bikerglen/p1am-proto-experiments/README.md

# p1am-proto-experiments
Various board and libraries to fit the Automation Direct P1AM-PROTO enclosure.
Everything here is untested. Use at your own risk. I'll accept pull requests with any corrections or other contributions.
