bikerglen/p1am-proto-experiments/p1am-isolated-rs485/boards/v1/p1am-proto-iso-rs485-schematic.png

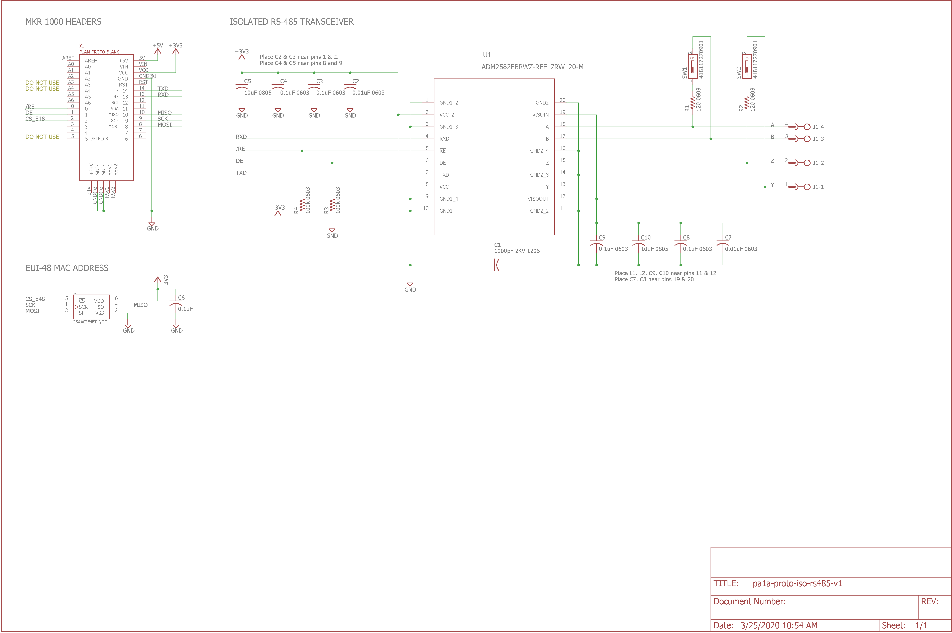
p1am-isolated-rs485/boards/v1/p1am-proto-iso-rs485-schematic.png
