bikerglen/p1am-proto-experiments/p1am-isolated-2x2-gpio/boards/v1/P1AM-ISOLATED-2X2-GPIO-BOM.xlsx

Qty | Ref | Description | Package | Mfr | Mfr Part # | Supplier | Supplier Part #
2 | C1, C2 | CAP CER 4.7UF 16V X7R 1206 | 1206 | Kemet | C1206C475K4RACTU | Digi-Key | 399-3524-1-ND
1 | C3 | CAP CER 0.1UF 16V X7R 1206 | 1206 | Kemet | C1206C104K4RACTU | Digi-Key | 399-9305-1-ND
1 | C4 | CAP CER 0.1UF 10V X7R 0805 | 0805 | Kemet | C0805C104K8RACTU | Digi-Key | 399-7999-1-ND
1 | C5 | CAP CER 1000pF 2KV 10% X7R SMD 1206 | 1206 | Johanson Dielectrics | 202R18W102KV4E | Digi-Key | 709-1036-1-ND
1 | C6 | CAP CER 0.1UF 50V X7R 0603 | 0603 | Kemet | C0603C104K5RACTU | Digi-Key | 399-5089-1-ND
2 | D1, D2 | DIODE GEN PURP 100V 150MA SOD123 | SOD123 | Micro Commercial Co | 1N4148W-TP | Digi-Key | 1N4148WTPMSCT-ND
1 | D3 | TVS DIODE 12V 29.5V SOD323 | SOD323 | Bourns Inc. | CDSOD323-T12SC | Digi-Key | CDSOD323-T12SCCT-ND
1 | D4 | TVS DIODE 7V/12V 14V/26V SOT23-3 | SOT23 | Bourns Inc. | CDSOT23-SM712 | Digi-Key | CDSOT23-SM712CT-ND
1 | DISP1-DISPLAY | LED DISPLAY 5X7 4CHAR 5MM RED | --- | Broadcom | HCMS-3962 | Digi-Key | 516-3920-ND
1 | DISP1-SOCKET | CONN IC DIP SOCKET 12POS GOLD | --- | Mill-Max | 299-43-312-11-001000 | Digi-Key | ED90160-ND
1 | J1 | CONN MOD JACK 8P8C R/A SHIELDED | 8P8C | TE Connectivity | 5558342-1 | Digi-Key | A31466-ND
1 | J2-HEADER | TERM BLOCK HDR 8POS 90DEG 3.5MM | --- | Würth Elektronik | 691322110008 | Digi-Key | 732-2774-ND
1 | J2-PLUG | TERM BLOCK PLUG 8POS STR 3.5MM | --- | Würth Elektronik | 691361100008 | Digi-Key | 732-2756-ND
2 | JP1, JP2 | CONN HEADER VERT 4POS 2.54MM | --- | Samtec | TSW-104-07-G-S | Digi-Key | SAM1029-04-ND
2 | K1, K2 | RELAY GEN PURPOSE SPDT 1A 5VDC | --- | Omron | G5V-1-DC5 | Digi-Key | Z773-ND
1 | PS1 | DC DC CONVERTER 5V 1W | --- | Cui | PDS1-S5-S5-S | Digi-Key | 102-2758-ND
2 | Q1, Q2 | TRANS NPN 50V 2A SOT23-3 | --- | Diodes Incorporated | FMMT619TA | Digi-Key | FMMT619CT-ND
2 | R1, R2 | RES SMD 750 OHM 5% 1/4W 1206 | 1206 | Panasonic | ERJ-8GEYJ751V | Digi-Key | P750ECT-ND
1 | R3 | RES SMD 120 OHM 5% 1/8W 0805 | 0805 | Panasonic | ERJ-6GEYJ121V | Digi-Key | P120ACT-ND
3 | R4, R7, R8 | RES SMD 10K OHM 5% 1/8W 0805 | 0805 | Panasonic | ERJ-6GEYJ103V | Digi-Key | P10KACT-ND
2 | R5, R6 | RES SMD 1K OHM 5% 1/4W 1206 | 1206 | Panasonic | ERJ-8GEYJ102V | Digi-Key | P1.0KECT-ND
1 | U1 | IC TRANSCEIVER HALF 1/1 8SOIC | --- | Texas Instruments | SN65HVD11DR | Digi-Key | 296-31717-1-ND
2 | U2,U3 | OPTOISO 3.75KV TRANSISTOR 4SOIC | --- | Broadcom | HCPL-181-000E | Digi-Key | 516-1646-1-ND
1 | U4 | IC EEPROM 2K SPI 10MHZ SOT23-6 | --- | Microchip | 25AA02E48T-I/OT | Digi-Key | 25AA02E48T-I/OTCT-ND
1 | X1 | P1AM PROTOTYPE HOUSING | --- | Automation Direct | P1AM-PROTO | Automation Direct | P1AM-PROTO
