bikerglen/p1am-proto-experiments/p1am-isolated-rs485/boards/v1/p1am-proto-iso-rs485-v1.brd

## EAGLE design p1am-isolated-rs485/boards/v1/p1am-proto-iso-rs485-v1.brd (2020-03-25)

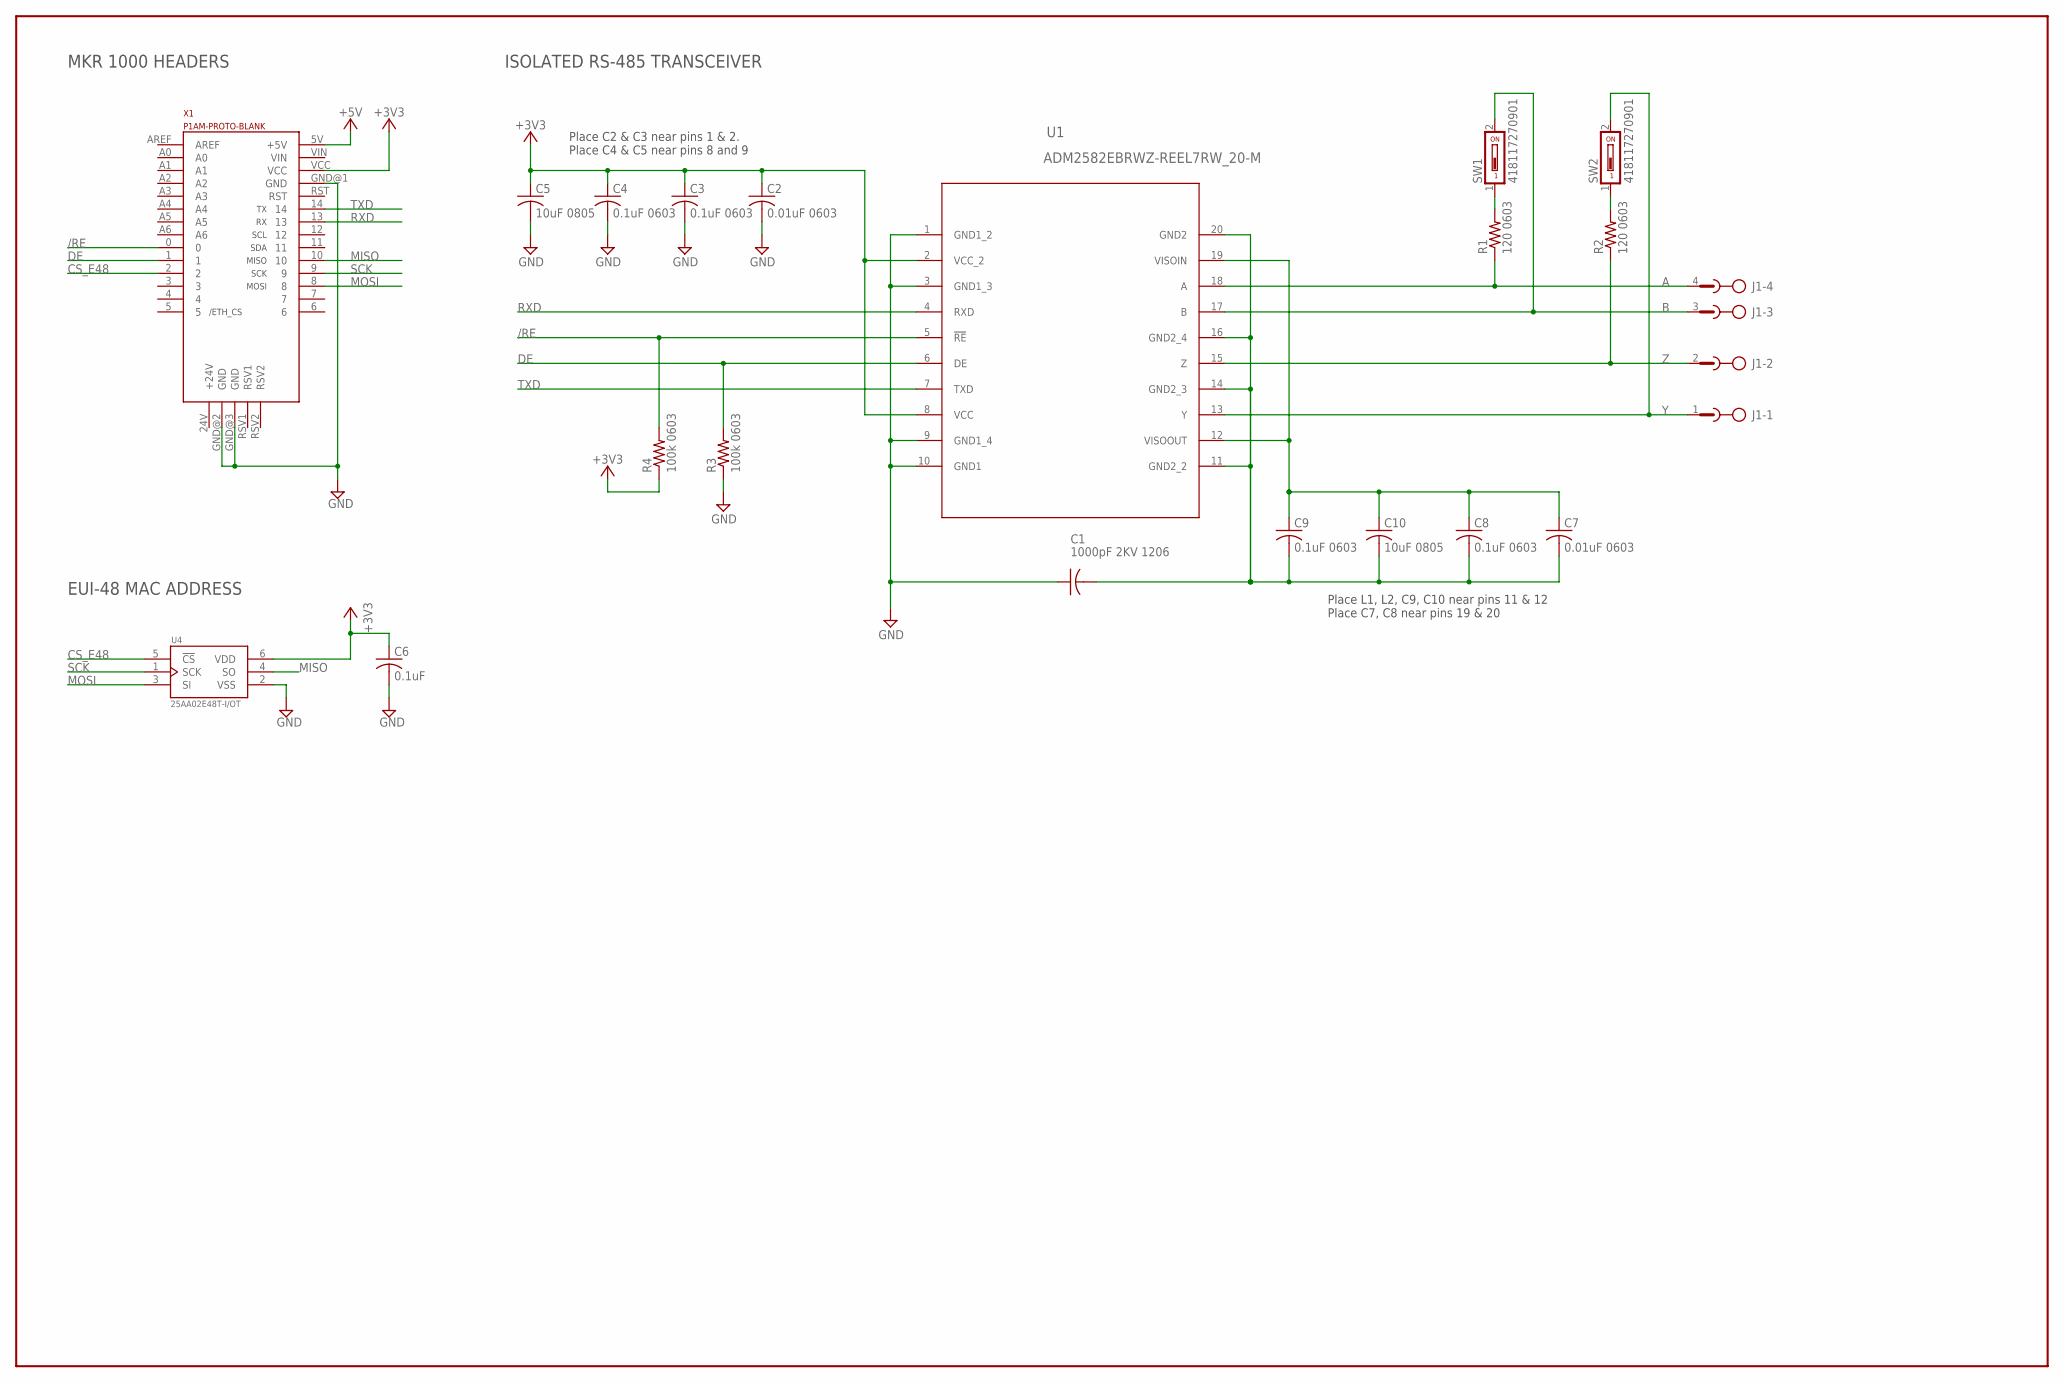
[picture p3: schematic p1am-proto-iso-rs485-v1.sch]

Parts:
C1: 1000pF 2KV 1206; C1206K
C2, C7: 0.01uF 0603; C0603K
C3, C4, C8, C9: 0.1uF 0603; C0603K
C5, C10: 10uF 0805; C0805K
C6: 0.1uF; C0603
J1: PHOENIX-XXXXXXX-TERM-BLOCK-HDR-4POS-90DEG-3.5MM
R1, R2: 120 0603; R0603
R3, R4: 100k 0603; R0603
SW1, SW2: 418117270901; DIP-01-PTH
U1: ADM2582EBRWZ-REEL7RW_20-M; RW_20-M
U4: 25AA02E48T-I/OT; SOT95P270X145-6N
X1: P1AM-PROTO-BLANK

Connections:
+3V3: C2.1, C3.1, C4.1, C5.1, C6.1, R4.1, U1.2 (VCC_2), U1.8 (VCC), U4.6 (VDD), X1.VCC
+5V: X1.5V (+5V)
/RE: R4.2, U1.5 (!RE), X1.0
A: J1.4, R1.1, U1.18 (A)
B: J1.3, SW1.2, U1.17 (B)
CS_E48: U4.5 (!CS), X1.2
DE: R3.2, U1.6 (DE), X1.1
GND: C1.1, C2.2, C3.2, C4.2, C5.2, C6.2, R3.1, U1.1 (GND1_2), U1.3 (GND1_3), U1.9 (GND1_4), U1.10 (GND1), U4.2 (VSS), X1.GND@1 (GND), X1.GND@2 (GND), X1.GND@3 (GND)
ISOGND: C1.2, C7.2, C8.2, C9.2, C10.2, U1.11 (GND2_2), U1.14 (GND2_3), U1.16 (GND2_4), U1.20 (GND2)
ISOVCC: C7.1, C8.1, C9.1, C10.1, U1.12 (VISOOUT), U1.19 (VISOIN)
MISO: U4.4 (SO), X1.10
MOSI: U4.3 (SI), X1.8
unnamed: R1.2, SW1.1
unnamed: R2.2, SW2.1
RXD: U1.4 (RXD), X1.13
SCK: U4.1 (SCK), X1.9
TXD: U1.7 (TXD), X1.14
Y: J1.1, SW2.2, U1.13 (Y)
Z: J1.2, R2.1, U1.15 (Z)

Notes on the sheet:
SCL
SDA
MISO
MOSI
SCK
/ETH_CS
MKR 1000 HEADERS
EUI-48 MAC ADDRESS
ISOLATED RS-485 TRANSCEIVER
Place C2 & C3 near pins 1 & 2. Place C4 & C5 near pins 8 and 9
Place L1, L2, C9, C10 near pins 11 & 12 Place C7, C8 near pins 19 & 20

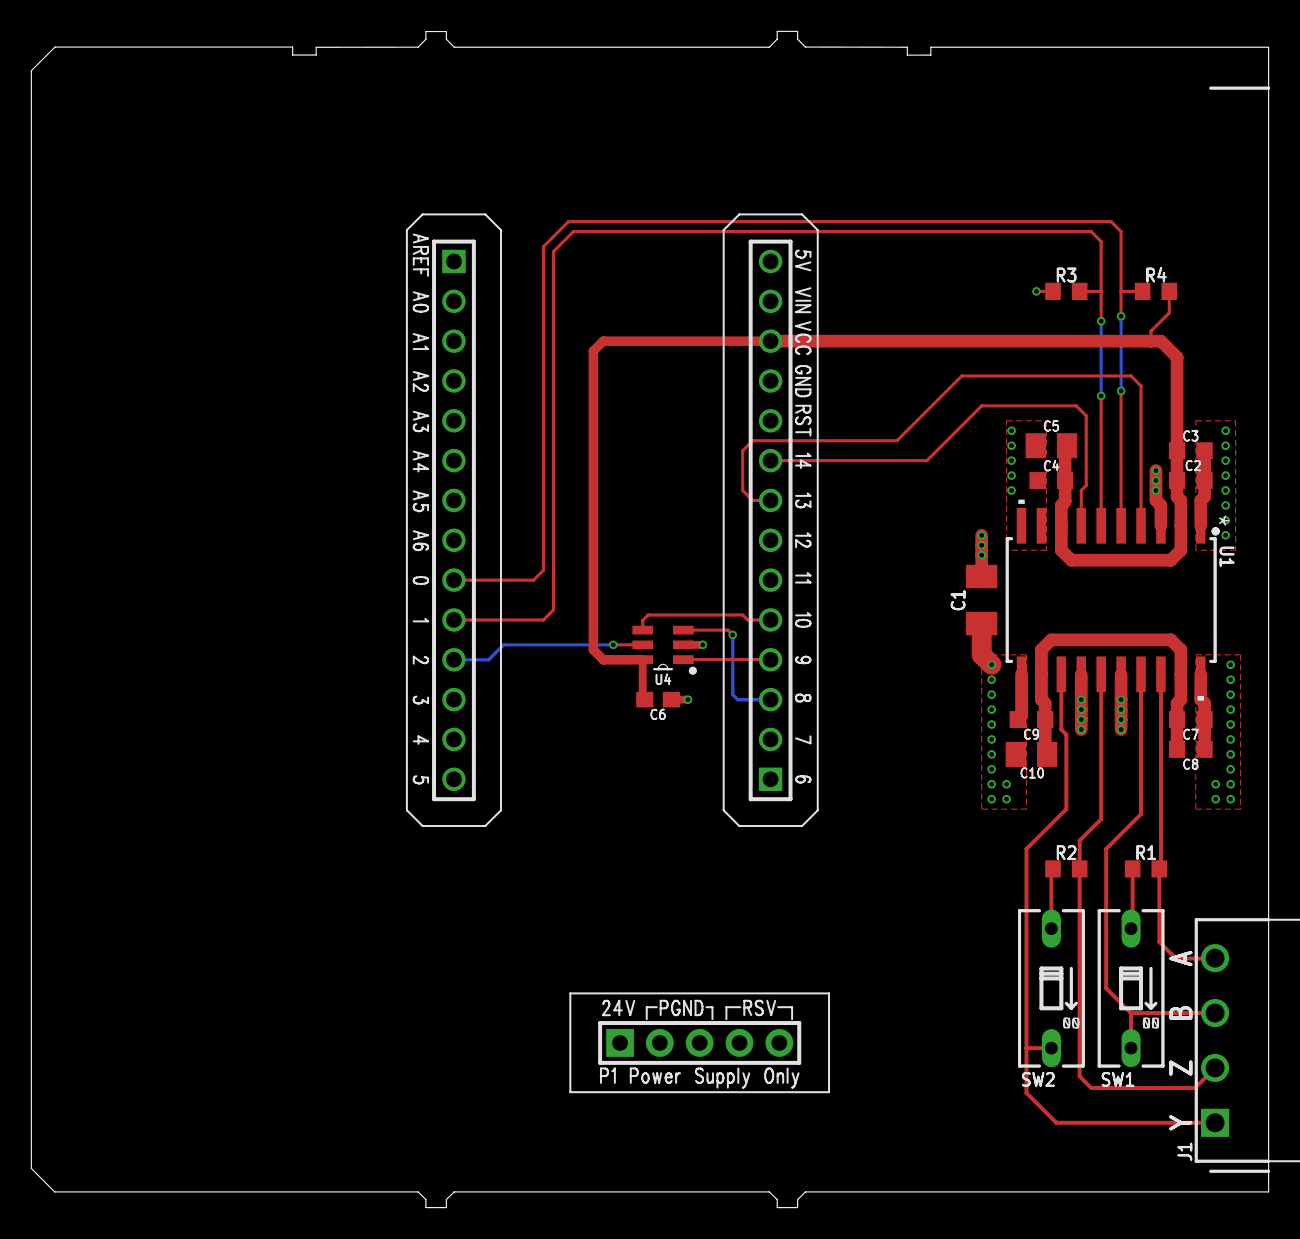
[picture p4: board p1am-proto-iso-rs485-v1.brd from above]

Board: 2 copper layers, 78.9 x 75.0 mm, 20 parts (0 on the bottom side), 18 nets.
