bikerglen/p1am-proto-experiments/p1am-isolated-2x2-gpio/boards/v1/P1AM-ISOLATED-2X2-GPIO.brd

## EAGLE design p1am-isolated-2x2-gpio/boards/v1/P1AM-ISOLATED-2X2-GPIO.brd (2020-03-22)

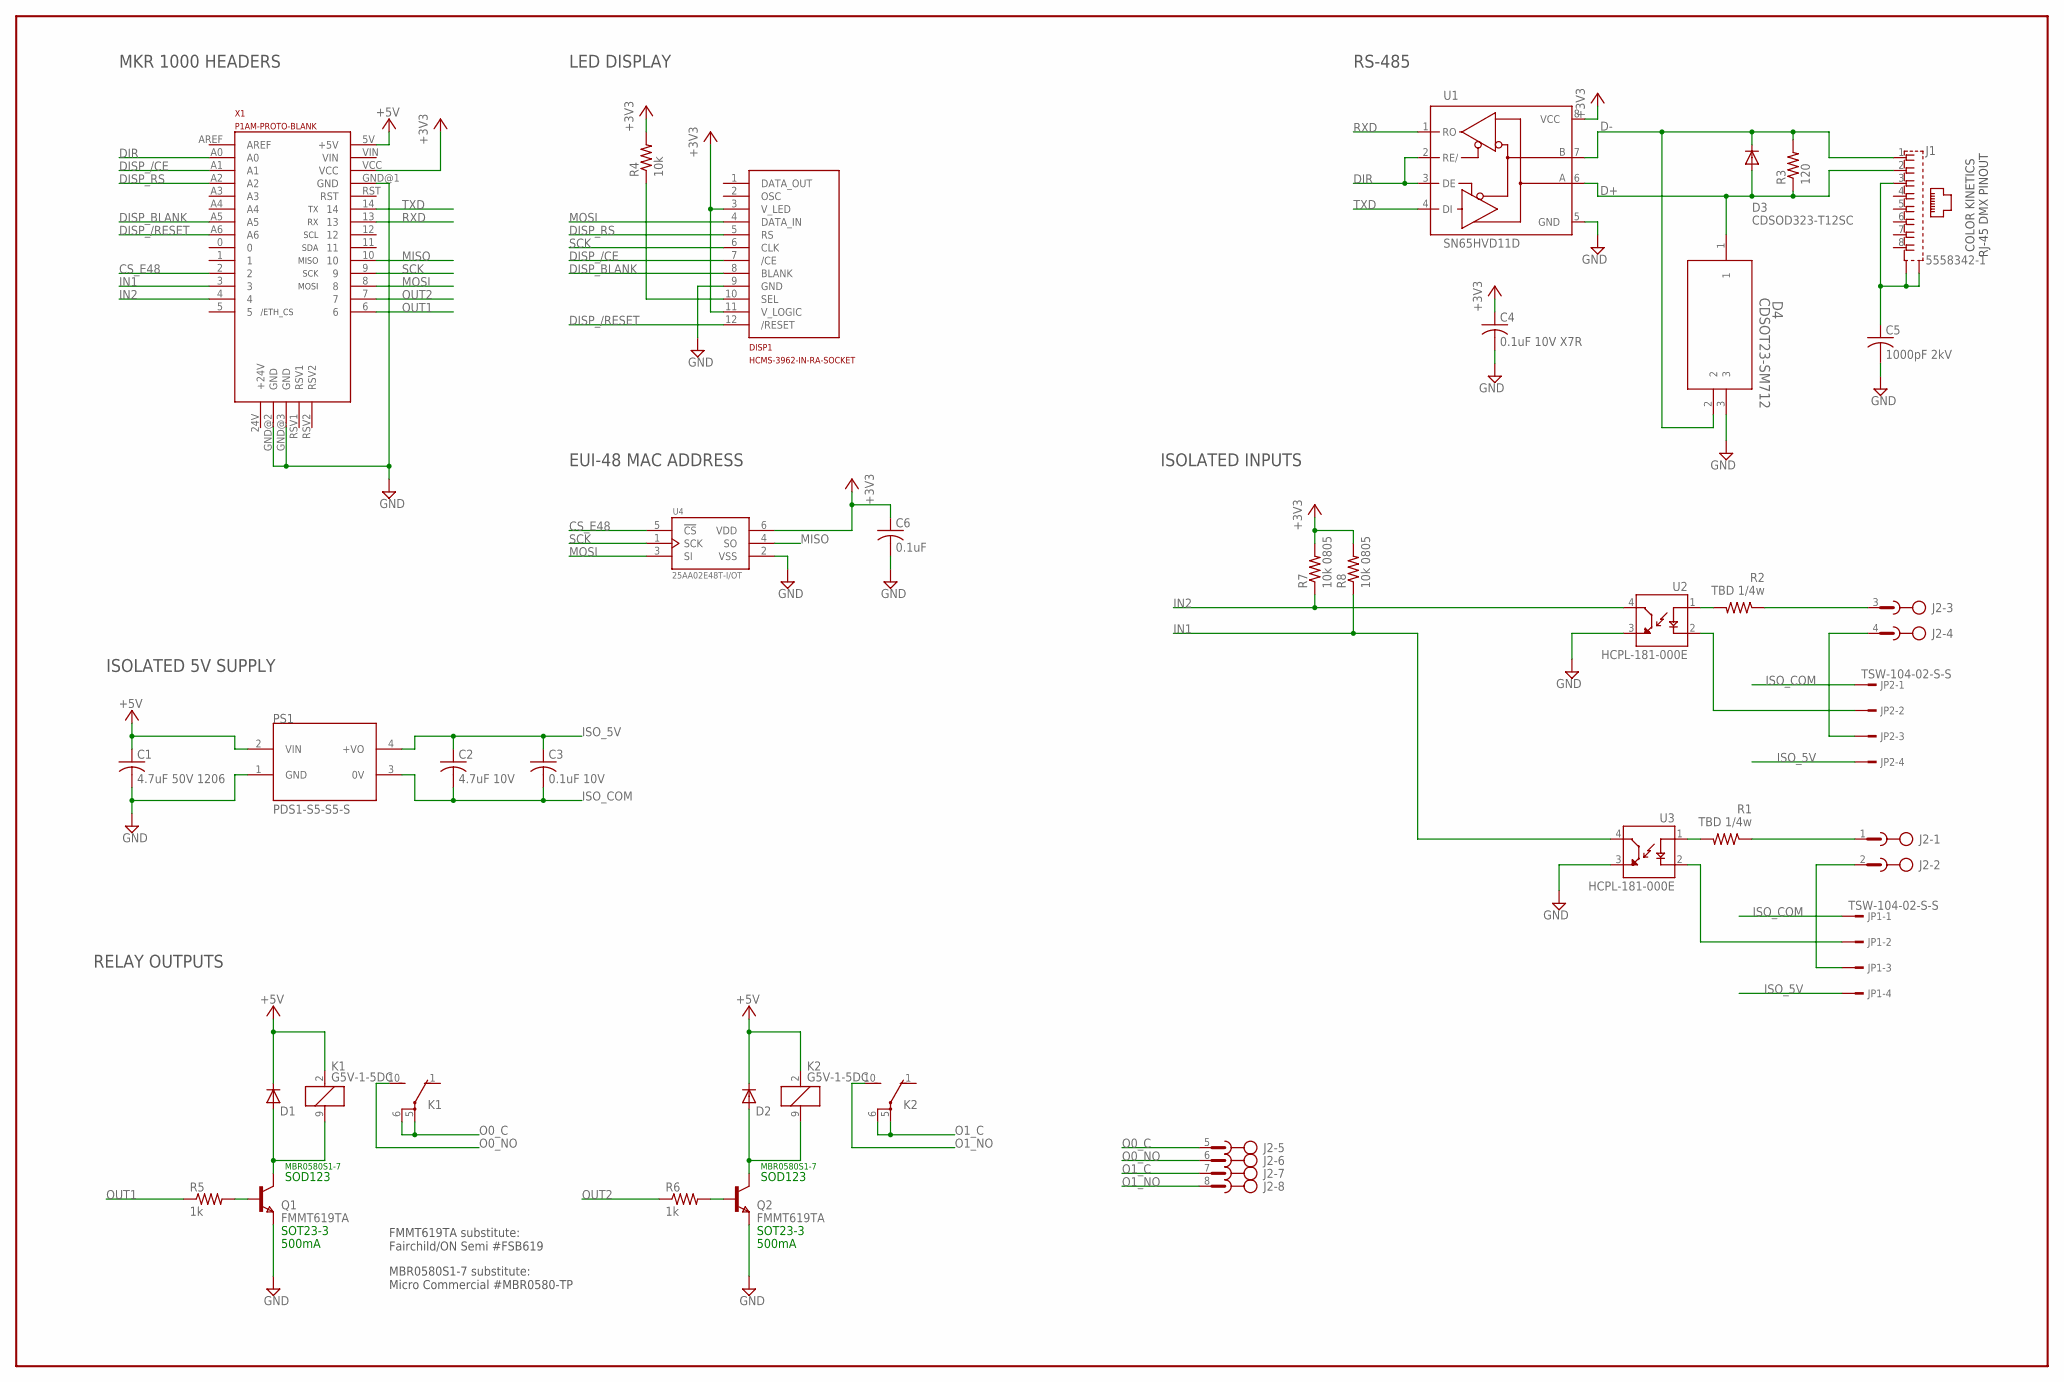
[picture p5: schematic P1AM-ISOLATED-2X2-GPIO.sch]

Parts:
C1: 4.7uF 50V 1206; C1206K; MFR_PART_NO C1206C475K5RACTU
C2: 4.7uF 10V; C1206K
C3: 0.1uF 10V; C1206K; MFR_PART_NO C1206C475K5RACTU
C4: 0.1uF 10V X7R; C0805
C5: 1000pF 2kV; C1206K
C6: 0.1uF; C0603
D1, D2: 1N4148W-TP; SOD123; MFR_PART_NO MBR0580S1-7
D3: CDSOD323-T12SC; SOD323-W
D4: CDSOT23-SM712; SOT_SM712
DISP1: HCMS-3962-IN-RA-SOCKET; 299-43-312-11-001000
J1: 5558342-1; TE_5558342-1
J2: PHOENIX-XXXXXXX-TERM-BLOCK-HDR-8POS-90DEG-3.5MM
JP1, JP2: TSW-104-02-S-S
K1, K2: G5V-1-5DC; G5V1; MFR_PART_NO G5V-1-DC5
PS1: PDS1-S5-S5-S; CONV_PDS1-S5-S5-S
Q1, Q2: FMMT619TA; SOT-23; MFR_PART_NO FMMT619TA
R1, R2: TBD 1/4w; R1206
R3: 120; R0805
R4: 10k; R0805
R5, R6: 1k; R1206; MFR_PART_NO CR1206-JW-102ELF
R7, R8: 10k 0805; R0805
U1: SN65HVD11D; SO08
U2, U3: HCPL-181-000E; SOIC254P675X240-4N
U4: 25AA02E48T-I/OT; SOT95P270X145-6N
X1: P1AM-PROTO-BLANK

Connections:
+3V3: C4.1, C6.1, DISP1.3 (V_LED), DISP1.11 (V_LOGIC), R4.2, R7.2, R8.2, U1.8 (VCC), U4.6 (VDD), X1.VCC
+5V: C1.1, D1.C, D2.C, K1.2 (1), K2.2 (1), PS1.2 (VIN), X1.5V (+5V)
CS_E48: U4.5 (!CS), X1.2
D+: D3.A, D4.1, J1.2, R3.1, U1.6 (A)
D-: D3.C, D4.2, J1.1, R3.2, U1.7 (B)
DIR: U1.2 (RE/), U1.3 (DE), X1.A0
DISP_/CE: DISP1.7 (/CE), X1.A1
DISP_/RESET: DISP1.12 (/RESET), X1.A6
DISP_BLANK: DISP1.8 (BLANK), X1.A5
DISP_RS: DISP1.5 (RS), X1.A2
GND: C1.2, C4.2, C5.2, C6.2, D4.3, DISP1.9 (GND), PS1.1 (GND), Q1.2 (E), Q2.2 (E), U1.5 (GND), U2.3 (EMITTER), U3.3 (EMITTER), U4.2 (VSS), X1.GND@1 (GND), X1.GND@2 (GND), X1.GND@3 (GND)
IN1: R8.1, U3.4 (COLLECTOR), X1.3
IN2: R7.1, U2.4 (COLLECTOR), X1.4
ISO_5V: C2.1, C3.1, JP1.4, JP2.4, PS1.4 (+VO)
ISO_COM: C2.2, C3.2, JP1.1, JP2.1, PS1.3 (0V)
MISO: U4.4 (SO), X1.10
MOSI: DISP1.4 (DATA_IN), U4.3 (SI), X1.8
unnamed: R1.2, U3.1 (ANODE)
unnamed: JP1.2, U3.2 (CATHODE)
unnamed: Q2.3 (B), R6.2
unnamed: D2.A, K2.9 (2), Q2.1 (C)
unnamed: J2.3, R2.1
unnamed: J2.2, JP1.3
unnamed: R2.2, U2.1 (ANODE)
unnamed: JP2.2, U2.2 (CATHODE)
unnamed: J2.1, R1.1
unnamed: J2.4, JP2.3
unnamed: C5.1, J1.3, J1.SH1 (S1), J1.SH2 (S2)
unnamed: DISP1.10 (SEL), R4.1
unnamed: Q1.3 (B), R5.2
unnamed: D1.A, K1.9 (2), Q1.1 (C)
O0_C: J2.5, K1.5, K1.6
O0_NO: J2.6, K1.10 (S)
O1_C: J2.7, K2.5, K2.6
O1_NO: J2.8, K2.10 (S)
OUT1: R5.1, X1.6
OUT2: R6.1, X1.7
RXD: U1.1 (RO), X1.13
SCK: DISP1.6 (CLK), U4.1 (SCK), X1.9
TXD: U1.4 (DI), X1.14

Notes on the sheet:
SOD123
SOT23-3
500mA
MBR0580S1-7
FMMT619TA substitute: Fairchild/ON Semi #FSB619
MBR0580S1-7 substitute: Micro Commercial #MBR0580-TP
COLOR KINETICS RJ-45 DMX PINOUT
SCL
SDA
MISO
MOSI
SCK
/ETH_CS
RS-485
ISOLATED INPUTS
RELAY OUTPUTS
MKR 1000 HEADERS
LED DISPLAY
EUI-48 MAC ADDRESS
ISOLATED 5V SUPPLY

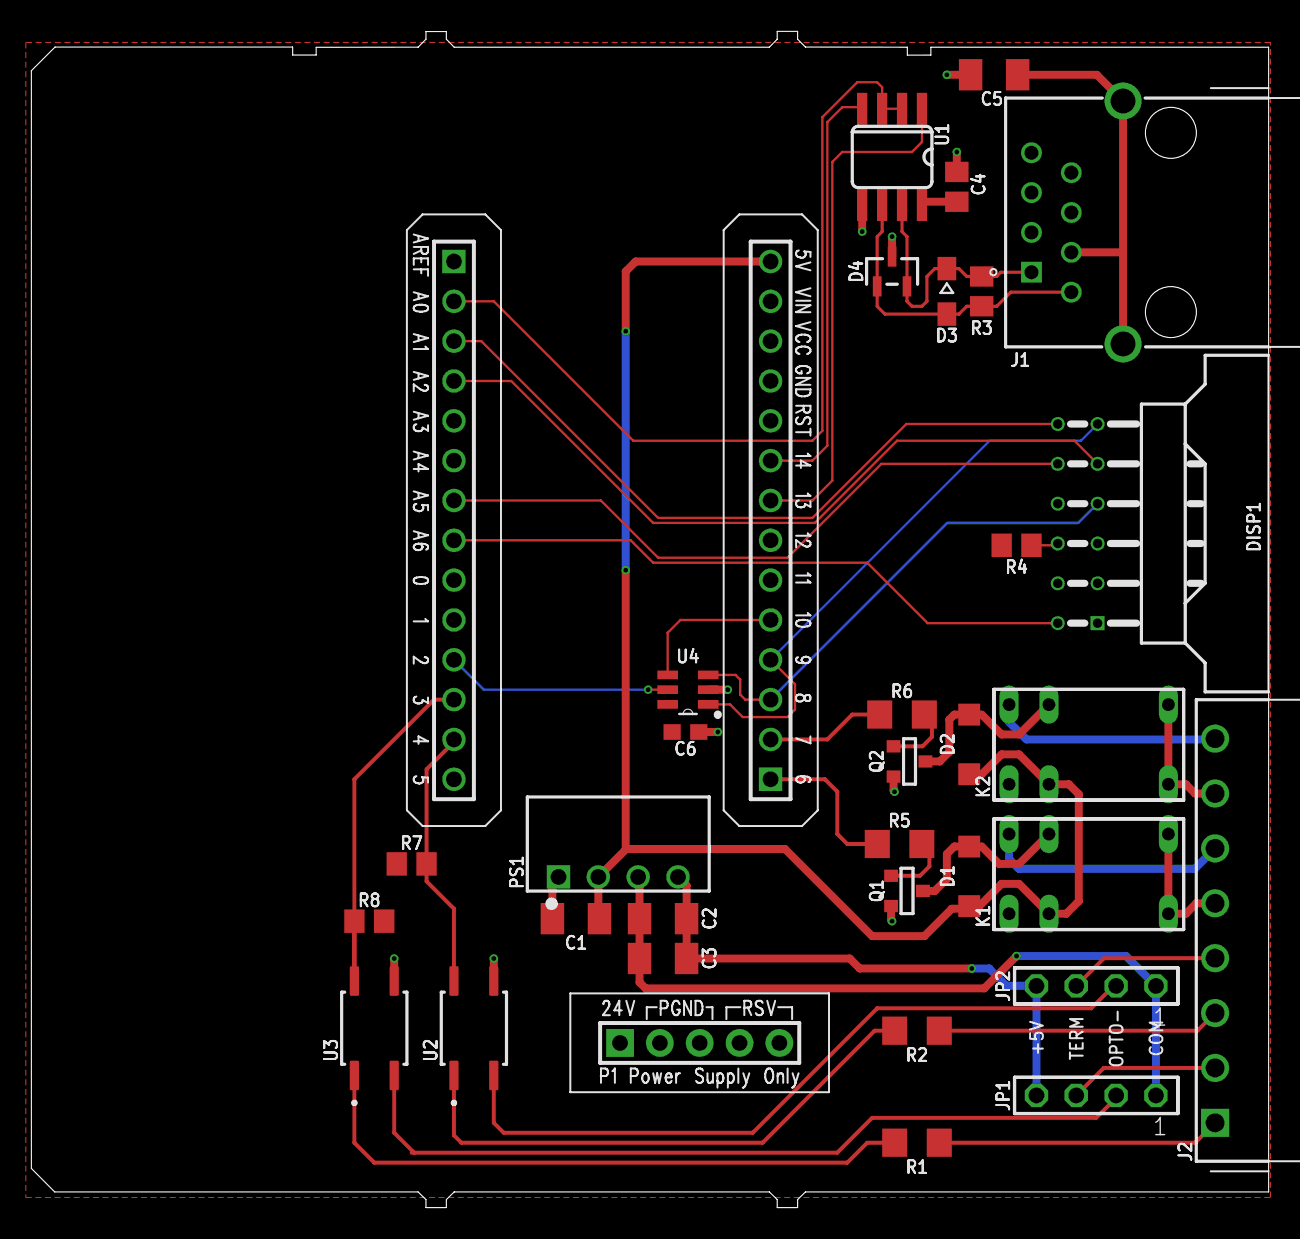
[picture p6: board P1AM-ISOLATED-2X2-GPIO.brd from above]

Board: 2 copper layers, 78.9 x 75.0 mm, 33 parts (0 on the bottom side), 40 nets.
