bikerglen/p1am-proto-experiments/p1am-isolated-2x2-gpio/sketches/p1am-100-garage-door-monitor/charrom.cpp

//-----------------------------------------------------------------------------
// includes

#include "charrom.h"


//-----------------------------------------------------------------------------
// globals
//

const unsigned char charrom[128][5] = {
	{ 0x7f, 0x00, 0x00, 0x00, 0x00 }, // bar graph 1
	{ 0x7f, 0x7f, 0x00, 0x00, 0x00 },
	{ 0x7f, 0x7f, 0x7f, 0x00, 0x00 },
	{ 0x7f, 0x7f, 0x7f, 0x7f, 0x00 },
	{ 0x7f, 0x7f, 0x7f, 0x7f, 0x7f },
	{ 0, 0, 0, 0, 0 },
	{ 0, 0, 0, 0, 0 },
	{ 0, 0, 0, 0, 0 },

	{ 0x00, 0x00, 0x00, 0x00, 0x7f }, // bar graph 2
	{ 0x00, 0x00, 0x00, 0x7f, 0x7f },
	{ 0x00, 0x00, 0x7f, 0x7f, 0x7f },
	{ 0x00, 0x7f, 0x7f, 0x7f, 0x7f },
	{ 0x7f, 0x7f, 0x7f, 0x7f, 0x7f },
	{ 0, 0, 0, 0, 0 },
	{ 0, 0, 0, 0, 0 },
	{ 0, 0, 0, 0, 0 },

	{ 0, 0, 0, 0, 0 }, { 0, 0, 0, 0, 0 },
	{ 0, 0, 0, 0, 0 }, { 0, 0, 0, 0, 0 },
	{ 0, 0, 0, 0, 0 }, { 0, 0, 0, 0, 0 },
	{ 0, 0, 0, 0, 0 }, { 0, 0, 0, 0, 0 },
	{ 0, 0, 0, 0, 0 }, { 0, 0, 0, 0, 0 },
	{ 0, 0, 0, 0, 0 }, { 0, 0, 0, 0, 0 },
	{ 0, 0, 0, 0, 0 }, { 0, 0, 0, 0, 0 },
	{ 0, 0, 0, 0, 0 }, { 0, 0, 0, 0, 0 },

	{ 0x00, 0x00, 0x00, 0x00, 0x00 }, // 0x20 space
	{ 0x00, 0x4f, 0x00, 0x00, 0x00 }, // !
	{ 0x00, 0x03, 0x00, 0x03, 0x00 }, // "
	{ 0x14, 0x7f, 0x14, 0x7f, 0x14 }, // #
	{ 0x24, 0x2a, 0x7f, 0x2a, 0x12 }, // $
	{ 0x23, 0x13, 0x08, 0x64, 0x62 }, // %
	{ 0x36, 0x49, 0x56, 0x20, 0x50 }, // &
	{ 0x00, 0x0b, 0x07, 0x00, 0x00 }, // '
	{ 0x00, 0x00, 0x3e, 0x41, 0x00 }, // 0x28 (
	{ 0x00, 0x41, 0x3e, 0x00, 0x00 }, // )
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
	{ 0x04, 0x48, 0x30, 0x08, 0x04 }, // y
	{ 0x44, 0x64, 0x54, 0x4c, 0x44 }, // z
	{ 0x00, 0x08, 0x36, 0x41, 0x00 }, // {
	{ 0x00, 0x00, 0x7f, 0x00, 0x00 }, // |
	{ 0x00, 0x41, 0x36, 0x08, 0x00 }, // }
	{ 0x08, 0x04, 0x08, 0x10, 0x08 }, // ~
	{ 0x2a, 0x55, 0x2a, 0x55, 0x2a }, // checker
};
