bikerglen/p1am-proto-experiments/(commit log)

2020-03-09 made board outline an unbroken continous line
2020-03-22 added schematic, board, and bom
    [P1AM-ISOLATED-2X2-GPIO-BOM.xlsx, P1AM-ISOLATED-2X2-GPIO.brd, P1AM-ISOLATED-2X2-GPIO.sch]
2020-03-25 initial checkin of isolated RS-485 board
    [p1am-proto-iso-rs485-bom.xlsx, pa1a-proto-iso-rs485-v1.brd, pa1a-proto-iso-rs485-v1.sch]
2020-04-04 fixed board names
    [p1am-proto-iso-rs485-v1.brd, p1am-proto-iso-rs485-v1.sch]
