bikerglen/p1am-proto-experiments/(notices)

Notices in the files:
parts and their libraries:
COPYRIGHT: Copyright (C) 2018 Accelerated Designs. All rights reserved
